mondaymakers/smart-button/PCB/PCB-3D.JPG

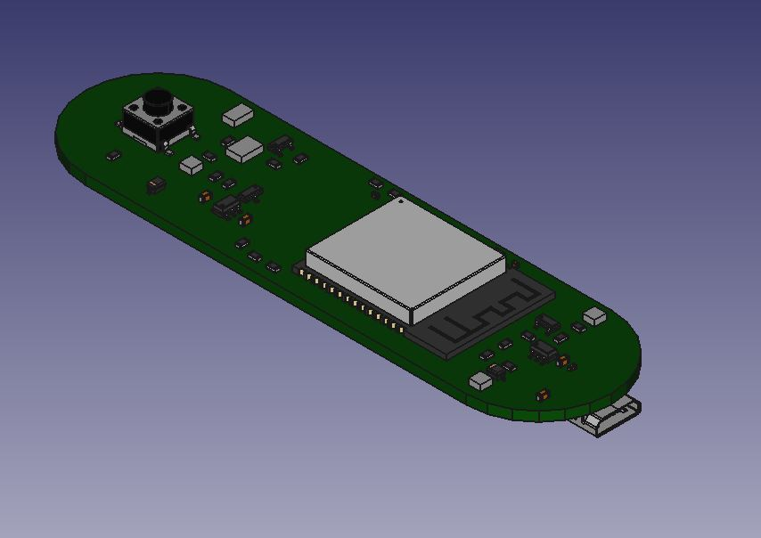
PCB/PCB-3D.JPG
