mondaymakers/smart-button/PCB/PCB1.JPG

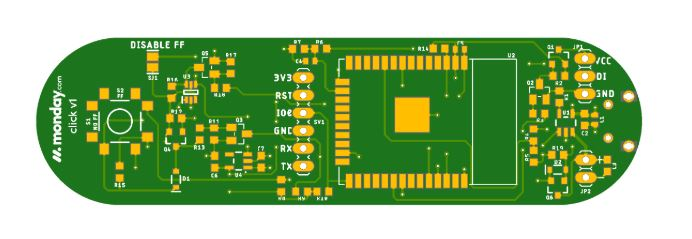
PCB/PCB1.JPG
