mondaymakers/smart-button/PCB/PCB2.JPG

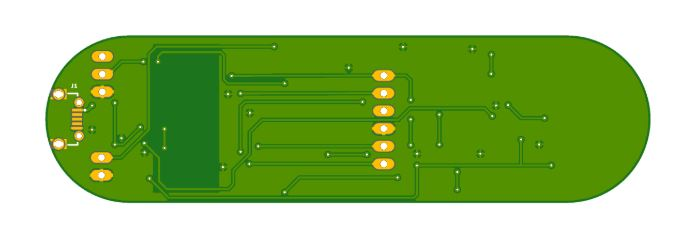
PCB/PCB2.JPG
