mondaymakers/smart-button/PCB/PCB.JPG

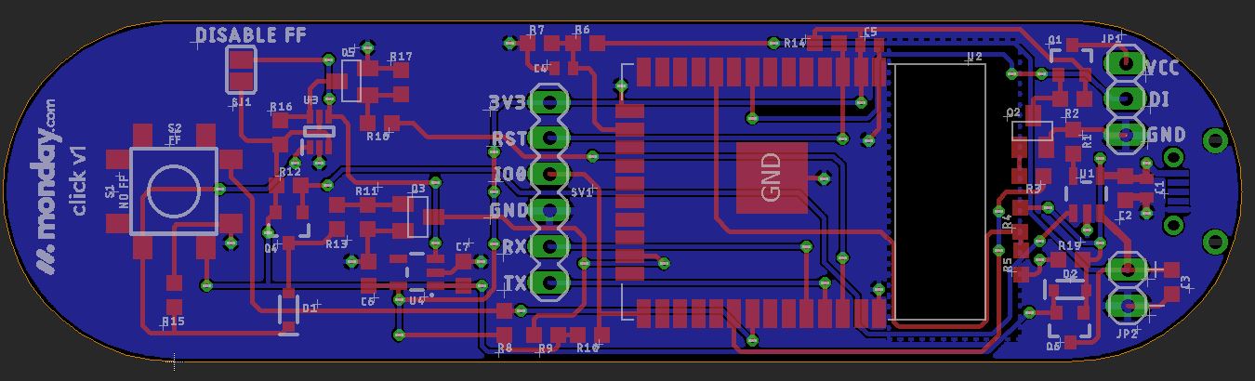
PCB/PCB.JPG
