mondaymakers/smart-button/PCB/ESP32 led flasher 3 - Bill of materials.xls

 |  | BOM (Bill of Materials)
Quantity | Designator | Description | Value | Footprint | Manufacturer | Part Number
3 | C1, C4, C5 | Cap Ceramic X7R | 100nF | 0402 | Various | 100nF 0402 10V 5% X7R
4 | C2, C3, C6, C7 | Cap Ceramic X7R | 10uF | 0603 | Various | 10uF 0603 10V 5% X7R
3 | D1, D2, D3 | Diode Schottky | BAT20J | SOD-323 | ST | BAT20J
1 | J1 | Connector micro USB | USB3076 | micro USB | GCT | USB3076-30-A
3 | Q1, Q4, Q6 | MOSFET P channel | AO3401A | SOT-23 | Alpha&Omega | AO3401A
4 | Q2, Q3, Q5, Q7 | NPN transistor | MMBT3904 | SOT-23 | Various | MMBT3904
1 | R1 | Resistor Chip SMD | 2K | 0603 | Various | 2K 0603 5%
13 | R2, R8, R9, R10, R11, R12, R14, R15, R16, R17, R19, R21, R22 | Resistor Chip SMD | 10K | 0603 | Various | 10K 0603 5%
4 | R3, R13, R18, R20 | Resistor Chip SMD | 1K | 0603 | Various | 1K 0603 5%
4 | R4, R5, R6, R7 | Resistor Chip SMD | 100K | 0603 | Various | 100K 0603 5%
1 | U1 | IC battery charger | MCP73832-2 | SOT23-5 | Microchip | MCP73832-2ACI/OT
1 | U2 | Microprocessor module | ESP32-WROOM-32D | ESP32-WROOM-32D | Espressif | ESP32-WROOM-32D
1 | U3 | Flip-flop D | SN74LVC1G175 | SC-70 | Texas Instruments | SN74LVC1G175DCK
1 | U4 | IC voltage regulator | AP2112K 3V3 | SOT23-5 | Diodes Inc. | AP2112K-3.3TRG1
1 | S2 | Momentary Switch (Pushbutton) - SPST | Tactile switch SMT | 6.2x6.2mm | E-switch | TL3301SPF260QG
1 | S1 | Not populate | - | - | - | -
