mondaymakers/smart-button/enclosure/3d print/base.stl

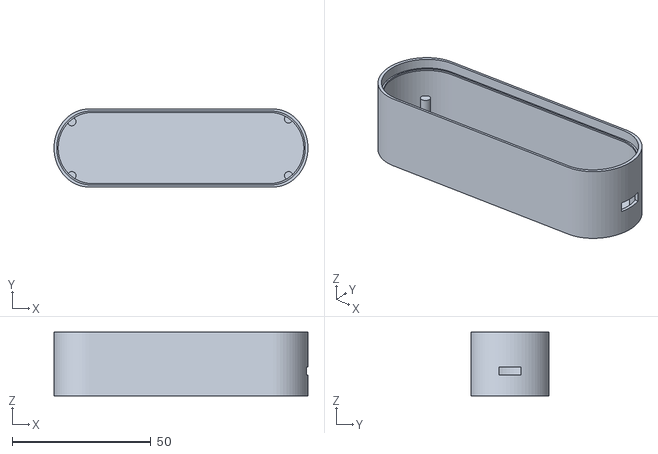
[picture p5: CAD file, 2021-11-16]
enclosure/3d print/base.stl
91.7 x 28.2 x 23.0
