mondaymakers/smart-button/enclosure/3d print/tactile switch adapter.stl

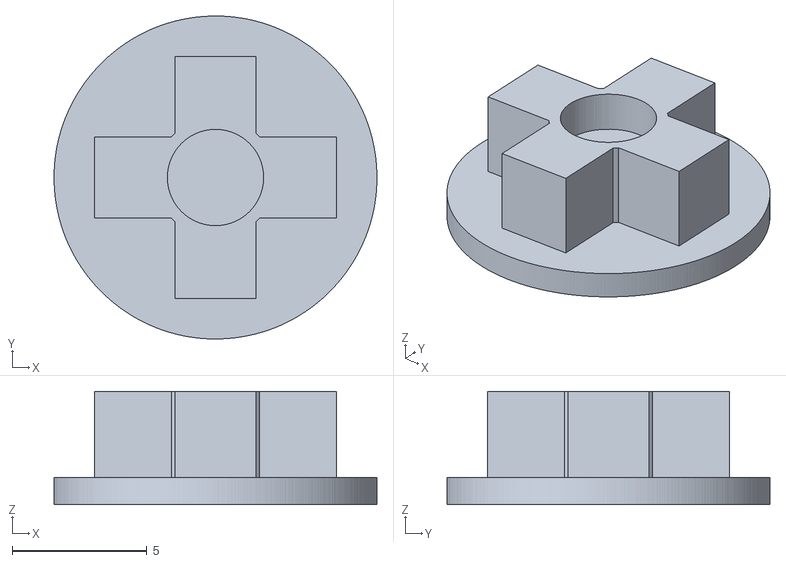
[picture p6: CAD file, 2021-11-16]
enclosure/3d print/tactile switch adapter.stl
12.0 x 12.0 x 4.20
