mondaymakers/smart-button/ESP32 programming board/Schematic.pdf

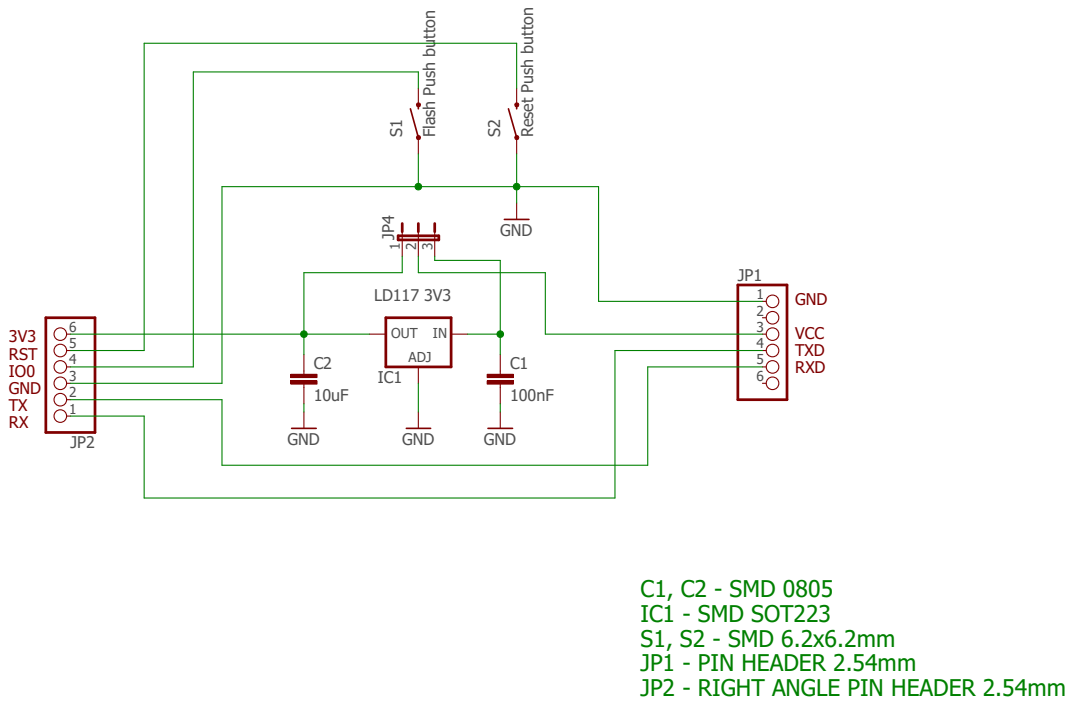
[picture p7: page 1]
GND; GND S1; ADJ; OUT IN IC1; 3 GND; VCC TXD RXD; 3V3 RST IO0 GND TX RX; Gravador ESP8266 26/04/2020 13:19 Sheet: 1/1

Flash Push button Reset Push button

C1, C2 - SMD 0805
IC1 - SMD SOT223
S1, S2 - SMD 6.2x6.2mm
JP1 - PIN HEADER 2.54mm
JP2 - RIGHT ANGLE PIN HEADER 2.54mm
