mondaymakers/smart-button/PCB/Schematic v3.pdf

C1 | R⁴ R⁵
SDI/SD1 | 22 | S2 | 1*2 3*2

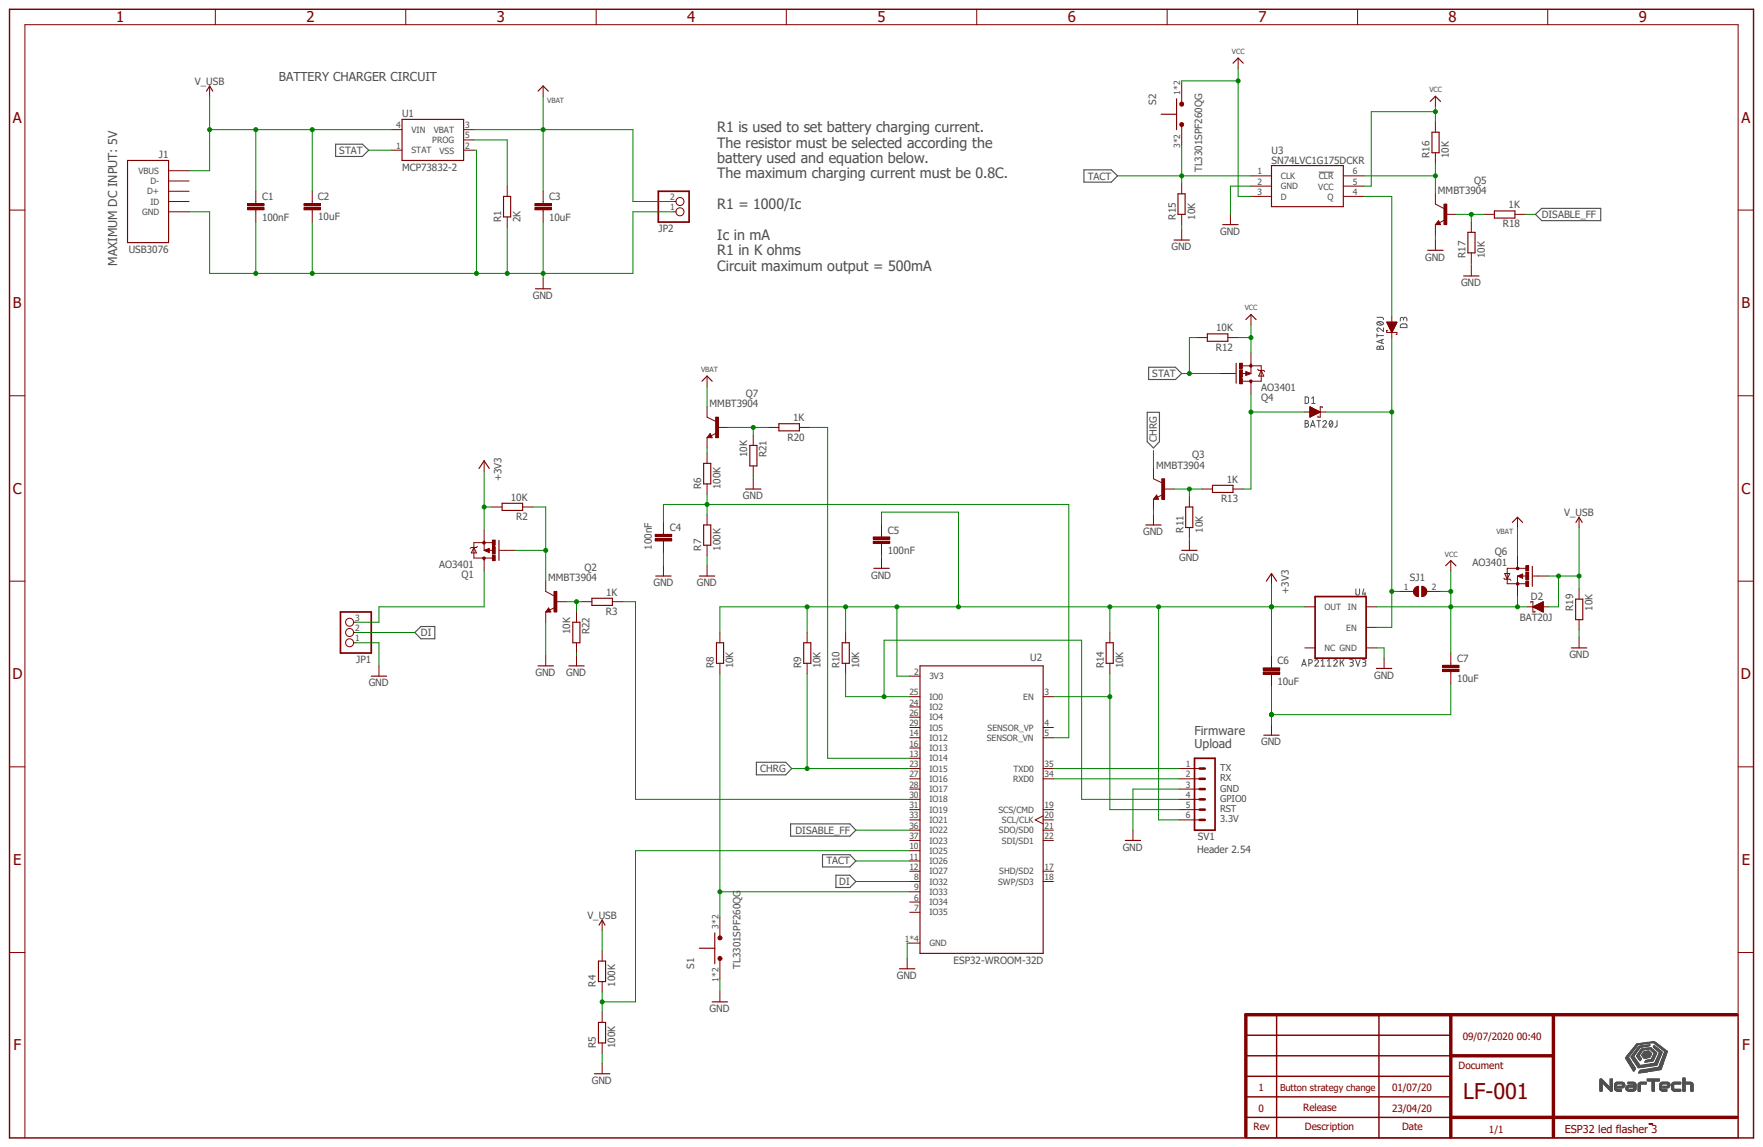
[picture p8: page 1]

R1 is used to set battery charging current.
The resistor must be selected according the
battery used and equation below.
The maximum charging current must be 0.8C.
R1 in K ohms
Circuit maximum output = 500mA

09/07/2020 00:40
Document LF-001

0 | Release | 23/04/20
Rev | Description | Date | 1/1 | ESP32 led flasher 3
