mondaymakers/smart-button/PCB/ESP32 led flasher 3.brd

## EAGLE design PCB/ESP32 led flasher 3.brd (2021-11-16)

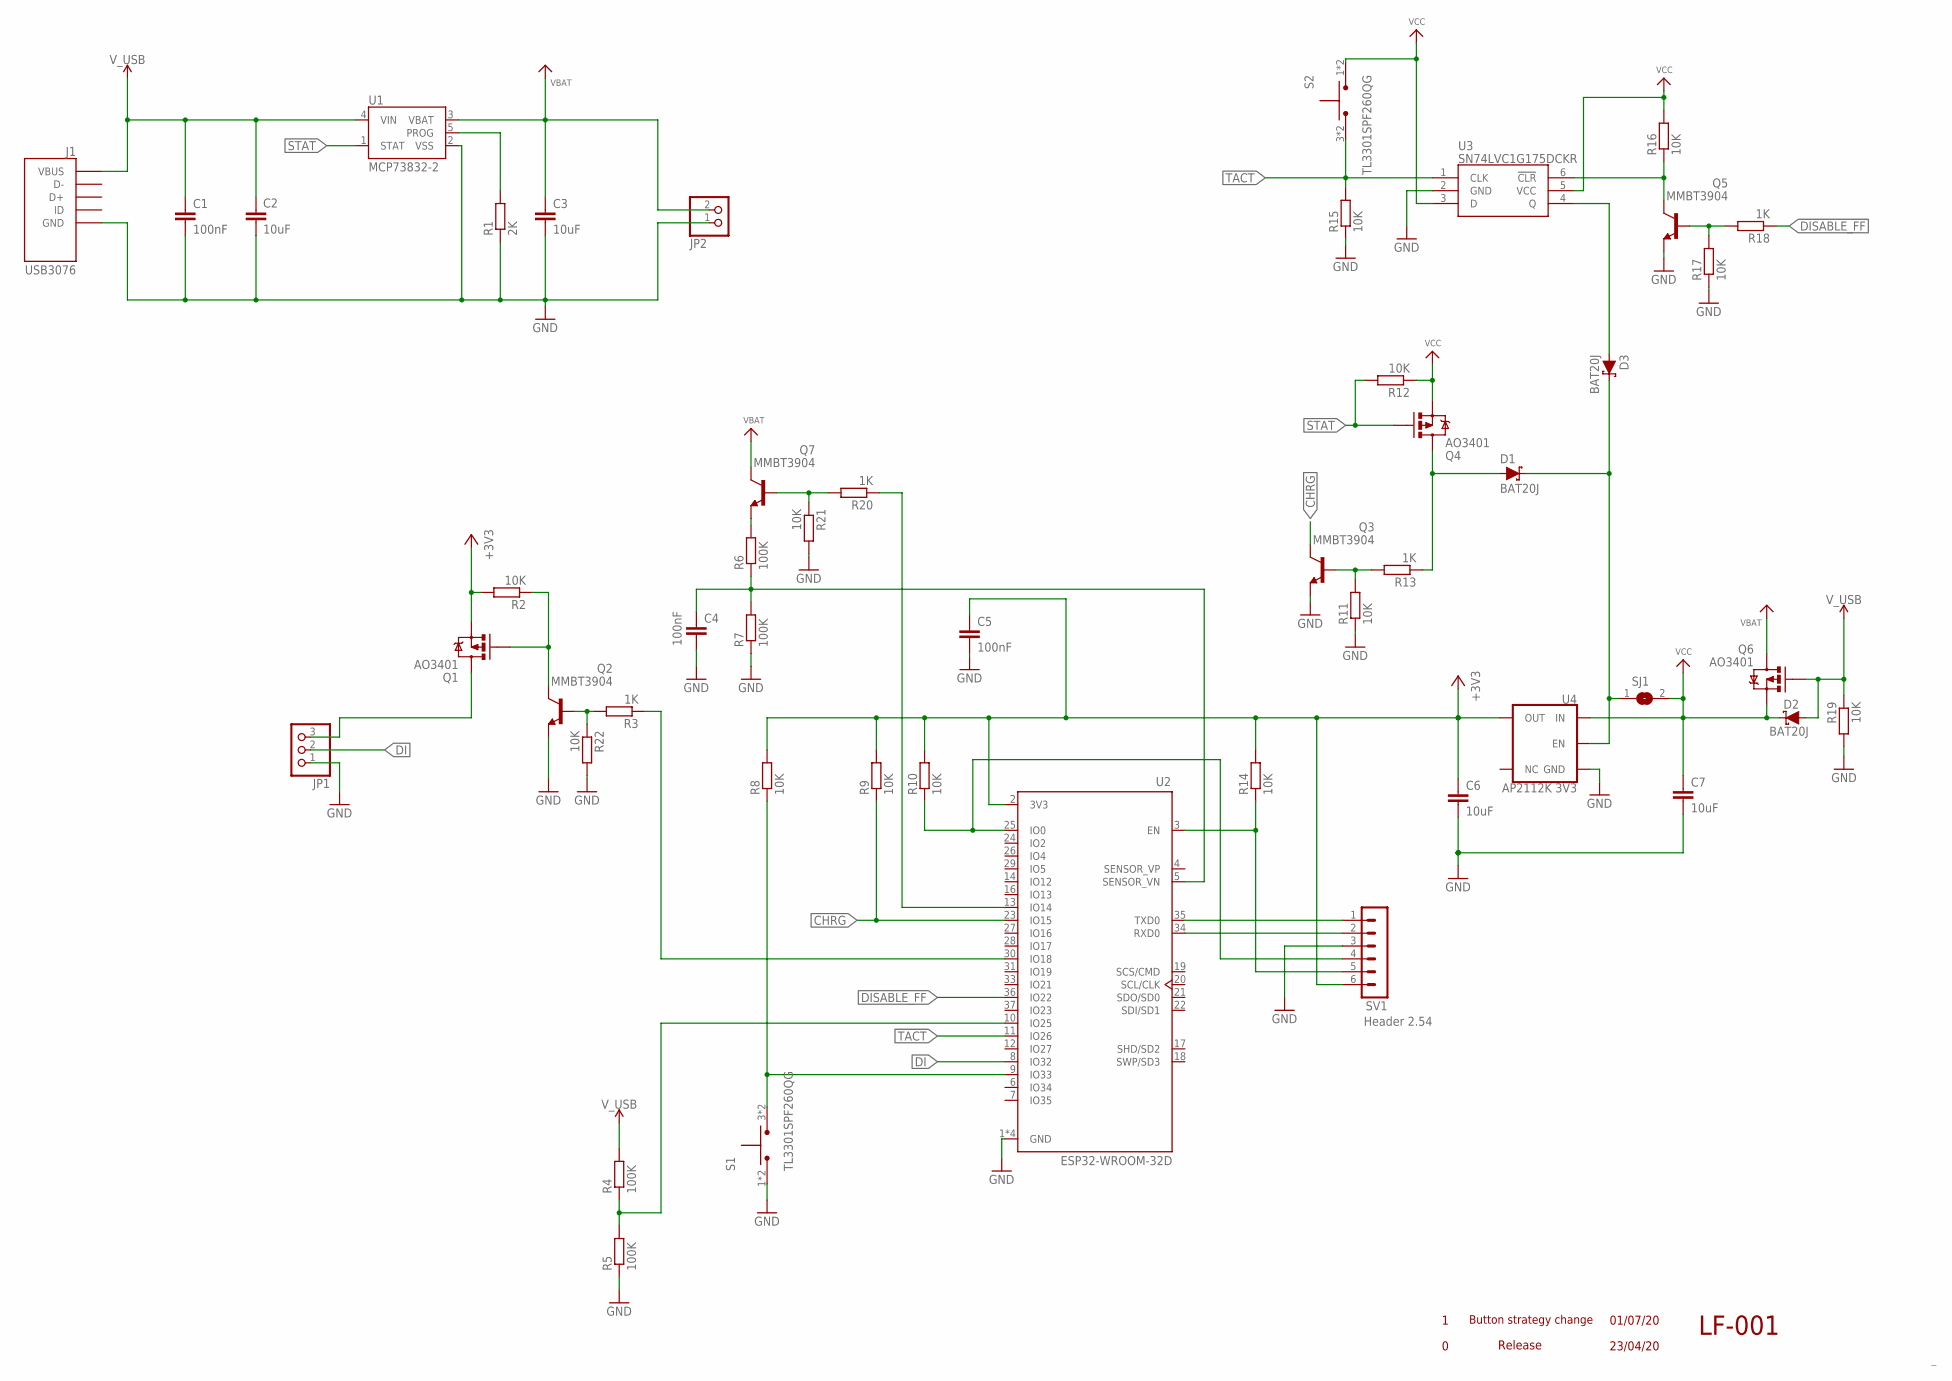
[picture p9: schematic ESP32 led flasher 3.sch]

Parts:
C1, C4, C5: 100nF; C0402
C2, C3, C6, C7: 10uF; C0603
D1, D2, D3: BAT20J; SOD-323
J1: USB3076; GCT_USB3076-XX-X_REVC
JP1: PINHD-1X3_2.54; 1X03
JP2: PINHD-1X2_2.54; 1X02
Q1, Q4, Q6: AO3401; SOT23-3@1
Q2, Q3, Q5, Q7: MMBT3904; SOT23
R1: 2K; R0603
R2, R8, R9, R10, R11, R12, R14, R15, R16, R17, R19, R21, R22: 10K; R0603
R3, R13, R18, R20: 1K; R0603
R4, R5, R6, R7: 100K; R0603
S1, S2: TL3301SPF260QG; SW_TL3301SPF260QG
SJ1: SOLDERJUMPERREFLOW; SOLDERJUMPER_REFLOW
SV1: Header 2.54; MA06-1
U1: MCP73832-2; SOT23-5
U2: ESP32-WROOM-32D; MODULE_ESP32-WROOM-32D
U3: SN74LVC1G175DCKR; SOP65P210X110-6N
U4: AP2112K 3V3; SOT23-5

Connections:
!CLR: Q5.3 (C), R16.1, U3.6 (!CLR)
+3V3: C5.1, C6.1, Q1.2 (S), R2.2, R8.2, R9.2, R10.2, R14.2, SV1.6, U2.2 (3V3), U4.5 (OUT)
CHRG: Q3.3 (C), R9.1, U2.23 (IO15)
DI: JP1.2, U2.8 (IO32)
DISABLE_FF: R18.1, U2.36 (IO22)
GND: C1.2, C2.2, C3.2, C4.2, C5.2, C6.2, C7.2, J1.5 (GND), JP1.1, JP2.1, Q2.2 (E), Q3.2 (E), Q5.2 (E), R1.1, R5.1, R7.1, R11.1, R15.1, R17.1, R19.2, R21.2, R22.2, S1.1, S1.2 (1), SV1.3, U1.2 (VSS), U2.1 (GND), U2.15 (GND), U2.38 (GND), U2.39 (GND), U3.2 (GND), U4.2 (GND)
unnamed: D1.A, Q4.3 (D), R13.1
unnamed: Q7.1 (B), R20.2, R21.1
unnamed: Q3.1 (B), R11.2, R13.2
unnamed: Q5.1 (B), R17.2, R18.2
unnamed: Q1.1 (G), Q2.3 (C), R2.1
unnamed: C4.1, R6.1, R7.2, U2.5 (SENSOR_VN)
unnamed: Q7.2 (E), R6.2
unnamed: R10.1, SV1.4, U2.25 (IO0)
unnamed: R14.1, SV1.5, U2.3 (EN)
unnamed: R1.2, U1.5 (PROG)
unnamed: SV1.1, U2.35 (TXD0)
unnamed: SV1.2, U2.34 (RXD0)
unnamed: R20.1, U2.13 (IO14)
unnamed: D3.A, U3.4 (Q)
unnamed: Q2.1 (B), R3.2, R22.1
unnamed: D1.C, D3.C, SJ1.1, U4.3 (EN)
unnamed: R8.1, S1.3 (2), S1.4 (2), U2.9 (IO33)
unnamed: R3.1, U2.30 (IO18)
unnamed: JP1.3, Q1.3 (D)
unnamed: R4.1, R5.2, U2.10 (IO25)
STAT: Q4.1 (G), R12.2, U1.1 (STAT)
TACT: R15.2, S2.3 (2), S2.4 (2), U2.11 (IO26), U3.1 (CLK)
VBAT: C3.1, JP2.2, Q6.3 (D), Q7.3 (C), U1.3 (VBAT)
VCC: C7.1, D2.C, Q4.2 (S), Q6.2 (S), R12.1, R16.2, S2.1, S2.2 (1), SJ1.2, U3.3 (D), U3.5 (VCC), U4.1 (IN)
V_USB: C1.1, C2.1, D2.A, J1.1 (VBUS), Q6.1 (G), R4.2, R19.1, U1.4 (VIN)

Notes on the sheet:
LF-001
Release
23/04/20
Button strategy change
01/07/20

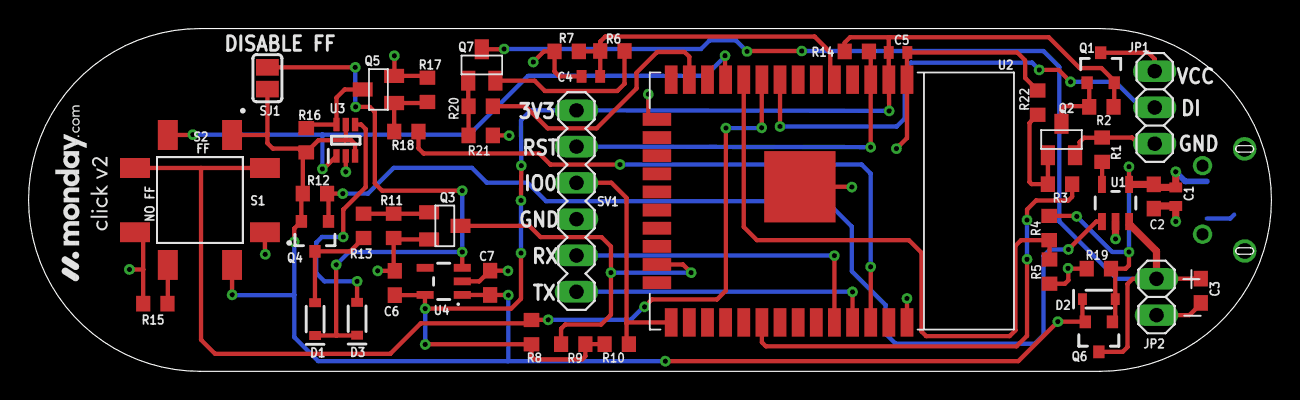
[picture p10: board ESP32 led flasher 3.brd from above]

Board: 2 copper layers, 87.0 x 24.0 mm, 50 parts (1 on the bottom side), 31 nets.
